prabudhgautam/Compass/Images/WhatsApp Image 2026-10-05 at 12.54.05 PM.jpeg

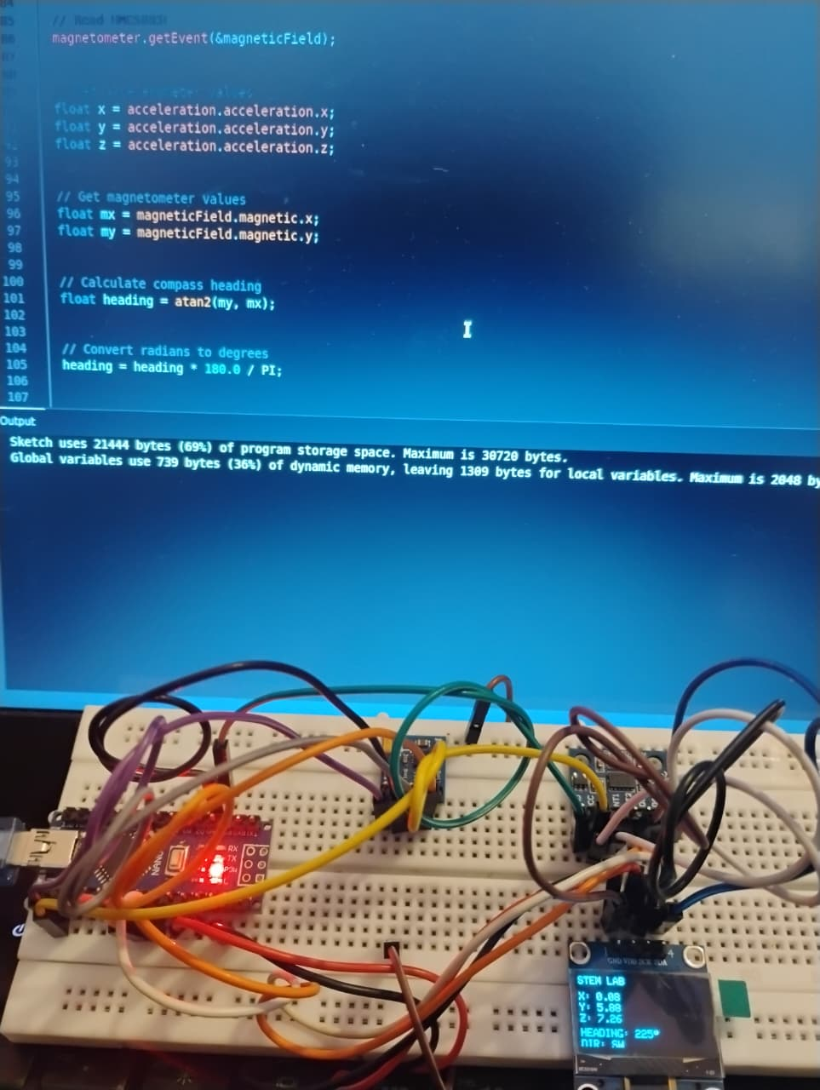
Images/WhatsApp Image 2026-10-05 at 12.54.05 PM.jpeg
